iamashrafulshuvo/Soccer-bot/(commit log)

2026-11-08 Create ESP32_Soccer_Robot_full code.ino
    Full code is here, ready to upload
2026-11-08 Rename ESP32_Soccer_Robot_full code.ino to ESP32_Soccer_Robot.ino
