iamashrafulshuvo/Soccer-bot/(notices)

Notices in the files:
README.md:
License: MIT
